lewis691/led-matrix-sim/reports/geometry/head-space-walkthrough.html

# Head space walkthrough

WT - Lewis.dxf (de-tilted 12°) overlaid with the Head 1 Assembly STEP. Model frame, mm: origin at the top-arc centre, +y up, +z out of the face. Step through below, or use the arrow keys.

## Front view, looking at the face (back-of-head parts seen through the board)

## Side section at x = 0 (face to the right, back of head to the left)

DXF / LED boarddiffusershell, bossescameraboard holesneck, mic, motorclear back patchrear-light candidatecentre line / camera height

Back

Next
