lewis691/led-matrix-sim/reports/full-head/full-head-60-optimized-report.pdf

# LeLamp Head: LED layout, light and heat

Generated 10/15/2026, 1:35:59 PM by Head LED Placement Studio · geometry from the Head STEP (gap 21 mm) · 60 LEDs at 55 mA, 3000 K, typical flux · dark room

## Summary

Light: 624 lm out (target 300), desk minimum 779 lx at 40 cm (target 500), evenness 6% (target 65%; outside the keepout corner: 88%). Only 40% of the LED light leaves through the diffuser; 42% is absorbed by the walls, chamfer and lip.
Heat (worst case): board 159 °C, LED chips 161 °C (datasheet limit 125), diffuser surface 102 °C, PLA bosses 159 °C (PLA softens ≈ 55 °C). 12.17 W in: LEDs 7.57 W + electronics 4.60 W.
Biggest passive lever: Black back + aluminium standoffs + Al Head Back → board 73 °C (-86 °C).
Warm-up: 95% of the temperature rise after 32 min; bench runs should last at least that long.
Fails: Evenness, Board temperature, LED junction, PLA bosses touching the board, Diffuser outside (touch), LED power, Supply headroom.

## Designs compared

Design | Gap | Current | Evenness | Variation | Light out | Desk min / avg | Board / LED chip | PLA bosses | Diffuser surface | LED power | Light: out / walls / camera ring
This design | 21 mm | 55 mA | 6% (outside the keepout corner 88%) | 21.9% | 624 lm | 779 / 961 lx | 159 / 161 °C | 159 °C | 102 °C | 8.91 W | 40% / 42% / 0.07%
Baseline: hex grid (21 mm, 55 mA) | 21 mm | 55 mA | 1% (outside the keepout corner 32%) | 39.4% | 742 lm | 906 / 1144 lx | 160 / 161 °C | 159 °C | 102 °C | 8.91 W | 48% / 31% / 0.04%

Every design is recomputed with the current model (heat: worst case). Targets: brief (300 lm, 65 %, 40 °C, 4 W, provisional); desk 500 lx at 40 cm (Ben's Notion, EN 12464-1); LED chip 125 °C (Cree Pro9 datasheet).

## This design

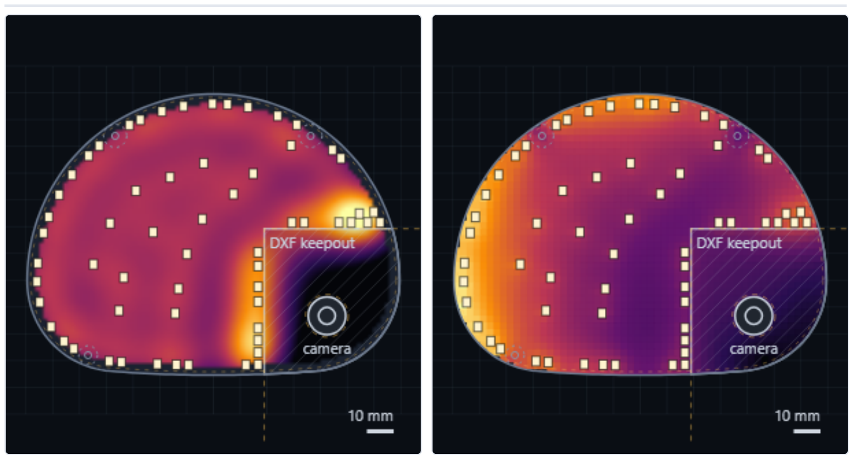
[picture p5: figure]

Diffuser brightness (yellow bright, purple dark), with the LED layout. Board temperature map (worst case): 156.9–159.5 °C.
Where the light goes
Destination | Share | Lumens
Out through the diffuser | 40% | 624
Absorbed / scattered in the diffuser | 17% | 267
Walls, chamfer and lip (dark PLA) | 42% | 649
Camera barrel | 0.5% | 8.3
Escapes undiffused round the camera | 0.07% | 1.1

Heat

Quantity | Value
Heat in | 12.17 W (LEDs 7.57 + electronics 4.60)
Leaves via | front 8.95 W · back cavity 2.77 W · bosses 0.46 W
Board hottest / coolest | 159.5 / 156.9 °C
Hottest LED chip | 161.1 °C (limit 125)
Diffuser outer surface (max) | 101.9 °C
Head Back inside / outside | 38.5 / 36.7 °C
Ben's network (LEDs only, front only) | 144.0 °C

Warm-up after switch-on

Orange: hottest board point; blue: diffuser; purple: shell. 63 % of the rise after 10 min, 95 % after 32 min. Lumped 3-node model; heat capacities from STEP volumes × typical material values (assumed).

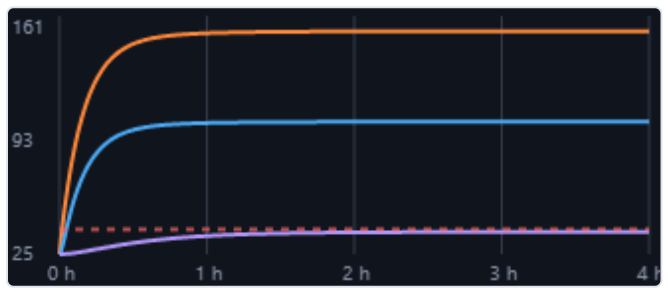
[picture p6: figure]

Passive cooling what-ifs (one change each)

Option | Board | Change | LED chip | PLA bosses
Board back painted / anodised black emissivity 0.1 → 0.9 (bare vs black-anodised aluminium, typical) | 116 °C | -43 °C | 118 °C | 116 °C
Aluminium standoffs instead of PLA bosses boss k 0.13 → 138 W/m·K | 158 °C | -2 °C | 159 °C | 156 °C
Head Back in PC instead of PLA wall k 0.13 → 0.2 W/m·K (Ben's PC value) | 158 °C | -1 °C | 160 °C | 157 °C
Head Back in aluminium wall k → 138 W/m·K; outside emissivity 0.85 (anodised, typical) | 154 °C | -6 °C | 155 °C | 153 °C
Electronics at typical power your table: 2.0 W instead of 4.6 W worst case | 139 °C | -21 °C | 140 °C | 138 °C
Electronics off this board LED heat only (as in Ben's calc) | 121 °C | -38 °C | 123 °C | 120 °C
Black back + aluminium standoffs + Al Head Back the three passive changes together | 73 °C | -86 °C | 75 °C | 64 °C

Which assumption matters most (one at a time)

Input | Range | Board low → high
Board back emissivity | bare 0.05 – painted 0.9 (finish unknown) | 166 → 116 °C
Air movement (Ben's cases) | Ben: Nu 1–3, h 2–25 | 113 → 159 °C
Electronics power | your table: 2.0 typical – 4.6 W worst | 139 → 159 °C
LED heat share k_h | Hui & Qin: 0.85; Qin & Hui: 85–90 % | 156 → 163 °C
Room temperature | 20–30 °C | 157 → 162 °C
PLA conductivity | 0.10–0.20 W/m·K (filament unknown) | 160 → 158 °C
Dielectric k (chip only) | MCPCB 1–3 W/m·K | 161 → 162 °C (chip)
Aluminium thickness | MCPCB 1.0–2.0 mm (stack-up unknown) | 160 → 159 °C
Shell emissivity | 0.80–0.95 | 160 → 159 °C

## Constraint checklist

| Check | Now | Limit | Limit from
✓ | Light out | 624 lm | ≥ 300 lm | Brief (provisional 300 lm)
✓ | Desk light (min) | 779 lx | ≥ 500 lx | Ben's Notion target (EN 12464-1)
✕ | Evenness | 6 % whole face (outside the keepout corner 88 %) | ≥ 65 % | Brief (provisional 65 %); scored over the whole lit face unless set to outside the keepout corner
✕ | Board temperature | 159.5 °C | ≤ 40 °C | Brief (provisional 40°C goal)
✕ | LED junction | 161.1 °C | ≤ 125 °C | Cree Pro9 datasheet p.4 (Tj max)
✕ | PLA bosses touching the board | 158.5 °C | ≤ 55 °C | PLA glass transition ≈ 55–60 °C (textbook); bosses from the STEP
✓ | Head Back inside (PLA) | 38.5 °C | ≤ 55 °C | PLA glass transition ≈ 55–60 °C (textbook)
✕ | Diffuser outside (touch) | 101.9 °C | ≤ 40 °C | Brief's 40°C goal applied to the touch point it asks you to probe
✕ | LED power | 8.91 W | ≤ 4 W | Brief / heat-calc doc (4 W reference)
✓ | Placement | 0 LED(s) break a limit | 0 | DXF outline, lens, screw holes, 2835 body size
✓ | Driver current | 55.0 mA | ≤ 60.5 mA | R82 = 820 Ω (Head_Board.pdf); 41 × 1.21 V / R from the TLC59711 datasheet (not in the context files)
✓ | LED current rating | 55.0 mA | ≤ 480 mA | Cree Pro9 datasheet p.4
✓ | Ambient rating | 25 °C | -40 to 105 °C | Cree Pro9 datasheet p.4
✕ | Supply headroom | -0.13 V | ≥ 0.4 V | LMR51420 divider (13.37 V) − 5 × Vf; TLC59711 regulation
✓ | Driver channels | 12 strings | ≤ 12 | TLC59711 (12 channels)

## Assumptions and values not in the project files

Item | Value | Basis
Driver current limit | 60.5 mA | R82 = 820 Ω from Head_Board.pdf × TLC59711 formula 41 × 1.21 V / R (datasheet not in the project files; its channel rating is 60 mA)
LED supply VDD_LED | 13.37 V | 100k/4.7k divider from Head_Board.pdf × LMR51420 0.6 V reference (datasheet not in the project files)
Regulation headroom limit | 0.4 V | my engineering choice
Metal-core stack-up | 1.6 mm Al k 138, 1 oz Cu, 0.1 mm dielectric k 2, back ε 0.1 | typical values until the PCB stack-up exists
PLA properties | k 0.13, ε 0.9, softens ≈ 55–60 °C | typical values; check the filament datasheet
Electronics placement | spread evenly | positions unknown
FR4 comparison | in-plane k 0.8, 1.6 mm | typical laminate value (comparison only)
Heat capacities (warm-up) | Al 2700 kg/m³ × 900, PC 1200 × 1200, PLA 1240 × 1800 J/kg·K | typical material values; volumes from the STEP
What-if materials | black back ε 0.9, Al standoffs/shell k 138, PC k 0.2, anodised ε 0.85 | typical values; PC k is Ben's value
Sensitivity ranges | e.g. back ε 0.05–0.9, PLA k 0.10–0.20, Al 1–2 mm, room 20–30 °C | typical spreads; air cases from Ben, power range from your table
Desk reflectance (Real look only) | 0.5 | display only
LED colour on screen | blackbody fit | Tanner Helland approximation (display only)
Optimizer settings, colour thresholds, clearances | e.g. penalty 50, 1.3 / 1.0 / 3.5 / 4.5 mm | my engineering choices (speed and safety margins, not physics)
Papers not in the project files | Su 2012, Du/Faber/Gunzburger 1999, Bridson 2007 | cited for algorithms only (optimizer, Even out, Randomize); context/papers holds Moreno, Yang, Hui & Qin

All other values trace to the Cree Pro9 datasheet, the Head STEP, Head_Board.pdf, the brief, Ben's Notion pages, the cited papers, or your answers. Full list: the app's Evidence panel (step 5) / evidence.js.

## Build record: LED positions

mm from the head's left / bottom edges (the dome centre is at x = 69.55, y = 35.47 in these units). Nearest-neighbour spacing 4.5–15.5 mm.

LED | String | Duty | x from left | y from bottom
1 | 12 | 100% | 30.62 | 5.24
2 | 11 | 100% | 86.21 | 12.99
3 | 9 | 100% | 8.93 | 18.08
4 | 8 | 100% | 56.52 | 32.31
5 | 11 | 100% | 86.21 | 8.45
6 | 11 | 100% | 55.71 | 3.88
7 | 11 | 100% | 81.70 | 3.80
8 | 6 | 100% | 30.96 | 56.72
9 | 11 | 100% | 60.24 | 3.77
10 | 10 | 100% | 86.22 | 27.46
11 | 8 | 100% | 86.22 | 32.99
12 | 10 | 100% | 86.22 | 3.94
13 | 7 | 100% | 8.02 | 59.10
14 | 4 | 100% | 65.94 | 79.17
15 | 8 | 100% | 86.22 | 40.75
16 | 10 | 100% | 34.32 | 24.11
17 | 3 | 100% | 16.69 | 74.83
18 | 10 | 100% | 86.22 | 17.58
19 | 7 | 100% | 3.95 | 41.86
20 | 12 | 100% | 13.77 | 12.67
21 | 8 | 100% | 86.21 | 45.89
22 | 9 | 100% | 4.70 | 27.24
23 | 10 | 100% | 55.27 | 23.11
24 | 3 | 100% | 38.15 | 93.39
25 | 9 | 100% | 36.07 | 36.50
26 | 7 | 100% | 47.06 | 53.42
27 | 12 | 100% | 35.17 | 4.87
28 | 7 | 100% | 6.08 | 53.14
29 | 6 | 100% | 98.90 | 57.02
30 | 2 | 100% | 98.55 | 85.79
31 | 1 | 100% | 50.32 | 98.52
32 | 8 | 100% | 59.65 | 45.25
33 | 9 | 100% | 24.76 | 41.41
34 | 2 | 100% | 113.98 | 84.12
35 | 5 | 100% | 124.06 | 60.30
36 | 7 | 100% | 11.91 | 67.38

LED | String | Duty | x from left | y from bottom
37 | 3 | 100% | 22.93 | 81.98
38 | 12 | 100% | 17.41 | 9.86
39 | 1 | 100% | 74.82 | 101.17
40 | 6 | 100% | 65.43 | 58.28
41 | 4 | 100% | 53.37 | 73.92
42 | 3 | 100% | 26.88 | 85.68
43 | 2 | 100% | 93.57 | 96.85
44 | 1 | 100% | 42.22 | 95.34
45 | 2 | 100% | 82.50 | 100.10
46 | 9 | 100% | 3.65 | 34.96
47 | 2 | 100% | 100.69 | 93.53
48 | 3 | 100% | 40.60 | 68.86
49 | 5 | 100% | 129.49 | 60.91
50 | 12 | 100% | 48.64 | 4.15
51 | 4 | 100% | 84.43 | 75.28
52 | 1 | 100% | 58.40 | 100.43
53 | 6 | 100% | 103.44 | 57.02
54 | 1 | 100% | 69.19 | 101.37
55 | 5 | 100% | 116.44 | 57.02
56 | 4 | 100% | 117.22 | 80.99
57 | 5 | 100% | 120.97 | 57.02
58 | 5 | 100% | 127.16 | 57.02
59 | 6 | 100% | 77.05 | 67.64
60 | 4 | 100% | 131.79 | 57.04

## Method and sources (short)

Light: each LED a cos^m (m = 1 from the 120° beam) source onto the diffuser at the optical height (17.9 − 0.62 mm), Moreno 2006 Eq. 1 × incidence cosine = Ben's derivation; walls absorb; diffuser transmission 0.70.
Desk: each diffuser patch a Lambertian source onto the desk plane (Ben's method). Evenness = darkest/average (brief); variation = CV (Yang 2009, Su 2012).
Heat: 2-D board conduction + Ben's front network + back cavity (STEP depths) + PLA bosses with radial spreading into the shell; LED heat k_h = 0.85 (Hui & Qin 2009); reduces exactly to Ben's network (check 20).
Checks: node checks/examples.js (26 checks against the sources) in the project repository.
