lewis691/led-matrix-sim/reports/bench/bench-B-optimized-20-led-coordinates.csv

led | string | position_in_string | x_mm | y_mm | nearest_neighbour_mm
1 | 3 | 3 | -65.58 | -4.82 | 24.30
2 | 3 | 4 | -52.57 | -25.34 | 23.65
3 | 3 | 5 | -28.98 | -27.00 | 23.65
4 | 2 | 2 | 16.64 | -30.76 | 22.01
5 | 1 | 2 | -39.83 | 3.33 | 27.01
6 | 2 | 1 | -5.35 | -31.81 | 22.02
7 | 2 | 3 | 16.66 | -8.75 | 22.01
8 | 3 | 2 | -62.37 | 21.29 | 23.16
9 | 1 | 3 | -25.32 | 28.91 | 27.40
10 | 1 | 1 | -12.14 | 0.17 | 27.87
11 | 2 | 4 | 16.64 | 13.27 | 22.02
12 | 4 | 5 | 39.82 | 21.55 | 22.09
13 | 4 | 4 | 61.90 | 21.55 | 22.01
14 | 3 | 1 | -51.16 | 41.55 | 23.16
15 | 1 | 4 | -31.38 | 57.93 | 22.05
16 | 2 | 5 | 1.21 | 35.72 | 27.24
17 | 4 | 2 | 29.66 | 51.66 | 22.04
18 | 4 | 3 | 51.59 | 40.99 | 22.01
19 | 1 | 5 | -10.51 | 65.04 | 22.05
20 | 4 | 1 | 11.96 | 64.80 | 22.04
