lewis691/led-matrix-sim/reports/bench/bench-baseline-and-A-hex-20-led-coordinates.csv

led | string | position_in_string | x_mm | y_mm | nearest_neighbour_mm
1 | 3 | 5 | -56.34 | -16.07 | 23.27
2 | 3 | 4 | -33.07 | -16.07 | 23.27
3 | 3 | 2 | -9.81 | -16.07 | 23.27
4 | 3 | 1 | 13.46 | -16.07 | 23.27
5 | 1 | 1 | -44.71 | 4.08 | 23.27
6 | 3 | 3 | -21.44 | 4.08 | 23.27
7 | 1 | 5 | 1.83 | 4.08 | 23.27
8 | 1 | 2 | -56.34 | 24.23 | 23.27
9 | 1 | 3 | -33.07 | 24.23 | 23.27
10 | 1 | 4 | -9.81 | 24.23 | 23.27
11 | 4 | 4 | 13.46 | 24.23 | 23.27
12 | 4 | 3 | 36.73 | 24.23 | 23.27
13 | 4 | 2 | 59.99 | 24.23 | 23.27
14 | 2 | 5 | -44.71 | 44.38 | 23.27
15 | 2 | 4 | -21.44 | 44.38 | 23.27
16 | 4 | 5 | 1.83 | 44.38 | 23.27
17 | 2 | 1 | 25.09 | 44.38 | 23.27
18 | 4 | 1 | 48.36 | 44.38 | 23.27
19 | 2 | 3 | -9.81 | 64.53 | 23.27
20 | 2 | 2 | 13.46 | 64.53 | 23.27
