lewis691/led-matrix-sim/reports/full-head/full-head-60-optimized-led-coordinates.csv

led | string | x_mm | y_mm | nearest_neighbour_mm
1 | 12 | -38.93 | -30.23 | 4.56
2 | 11 | 16.66 | -22.48 | 4.55
3 | 9 | -60.62 | -17.39 | 7.26
4 | 8 | -13.03 | -3.16 | 9.28
5 | 11 | 16.66 | -27.02 | 4.51
6 | 11 | -13.84 | -31.59 | 4.53
7 | 11 | 12.15 | -31.67 | 4.52
8 | 6 | -38.59 | 21.25 | 15.50
9 | 11 | -9.31 | -31.70 | 4.53
10 | 10 | 16.67 | -8.01 | 5.53
11 | 8 | 16.67 | -2.48 | 5.53
12 | 10 | 16.67 | -31.53 | 4.51
13 | 7 | -61.53 | 23.63 | 6.27
14 | 4 | -3.61 | 43.70 | 13.63
15 | 8 | 16.67 | 5.28 | 5.14
16 | 10 | -35.23 | -11.36 | 12.51
17 | 3 | -52.86 | 39.36 | 8.85
18 | 10 | 16.67 | -17.89 | 4.58
19 | 7 | -65.60 | 6.39 | 6.91
20 | 12 | -55.78 | -22.80 | 4.59
21 | 8 | 16.66 | 10.42 | 5.14
22 | 9 | -64.85 | -8.23 | 7.79
23 | 10 | -14.28 | -12.36 | 9.28
24 | 3 | -31.40 | 57.92 | 4.51
25 | 9 | -33.48 | 1.02 | 12.33
26 | 7 | -22.49 | 17.95 | 15.01
27 | 12 | -34.38 | -30.60 | 4.56
28 | 7 | -63.47 | 17.67 | 6.27
29 | 6 | 29.35 | 21.55 | 4.54
30 | 2 | 29.00 | 50.32 | 8.03
31 | 1 | -19.23 | 63.05 | 8.31
32 | 8 | -9.90 | 9.78 | 13.32
33 | 9 | -44.79 | 5.94 | 12.33
34 | 2 | 44.43 | 48.65 | 4.51
35 | 5 | 54.52 | 24.83 | 4.51
36 | 7 | -57.64 | 31.91 | 8.85
37 | 3 | -46.62 | 46.51 | 5.41
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
