lewis691/led-matrix-sim/reports/bench/bench-strings-B-back.png

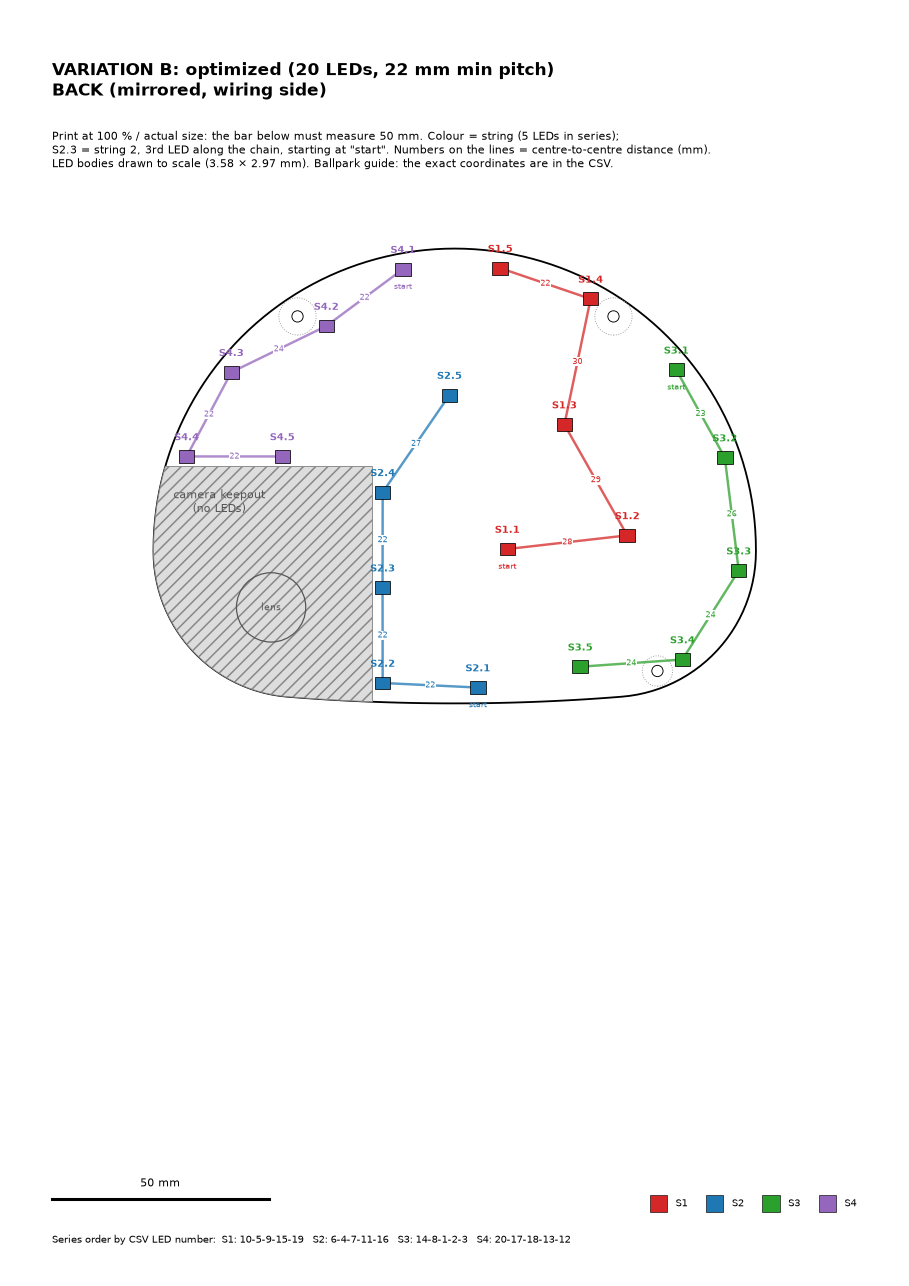
reports/bench/bench-strings-B-back.png
