lewis691/led-matrix-sim/reports/bench/bench-strings-B-front.png

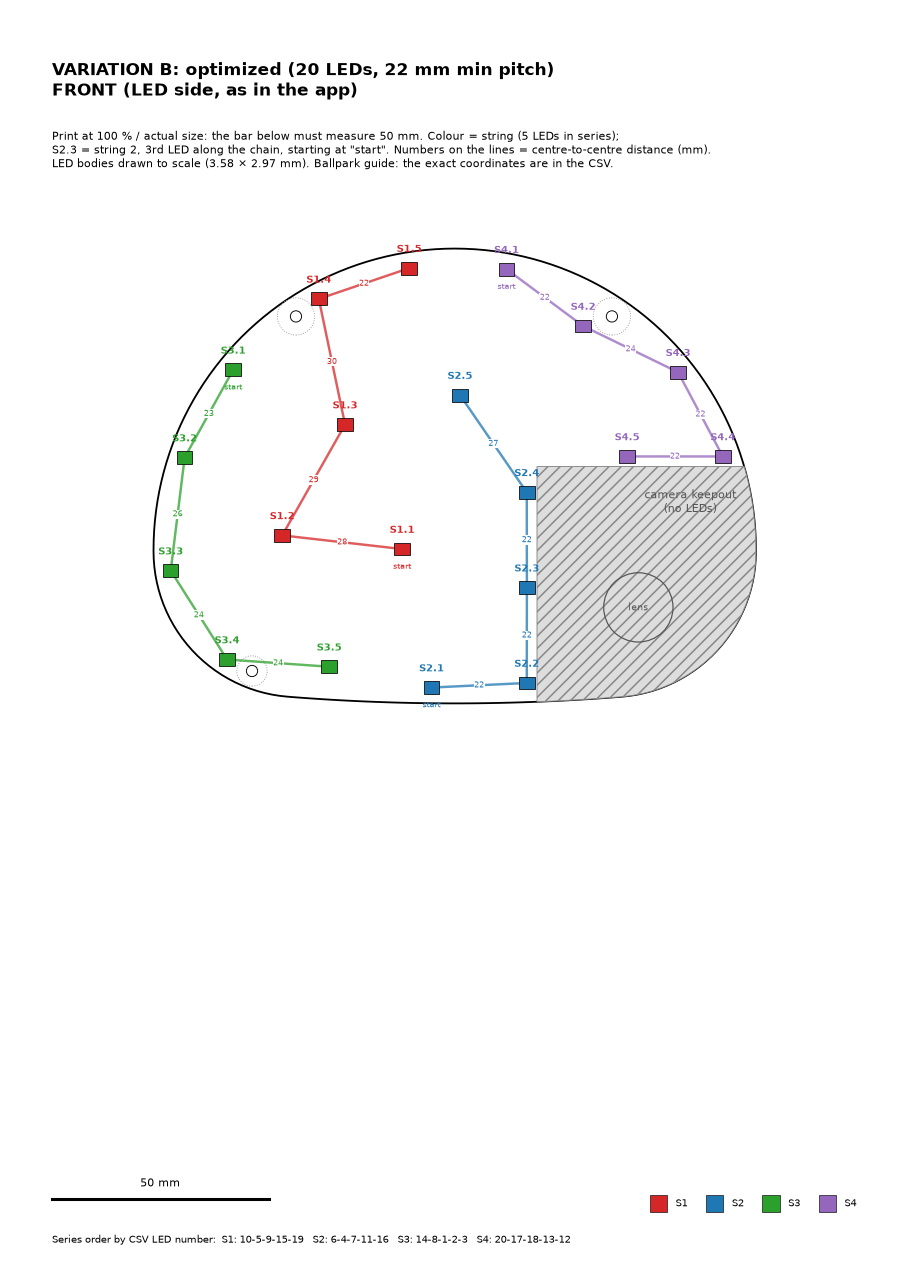
reports/bench/bench-strings-B-front.png
