lewis691/led-matrix-sim/reports/bench/bench-strings-hex-back.png

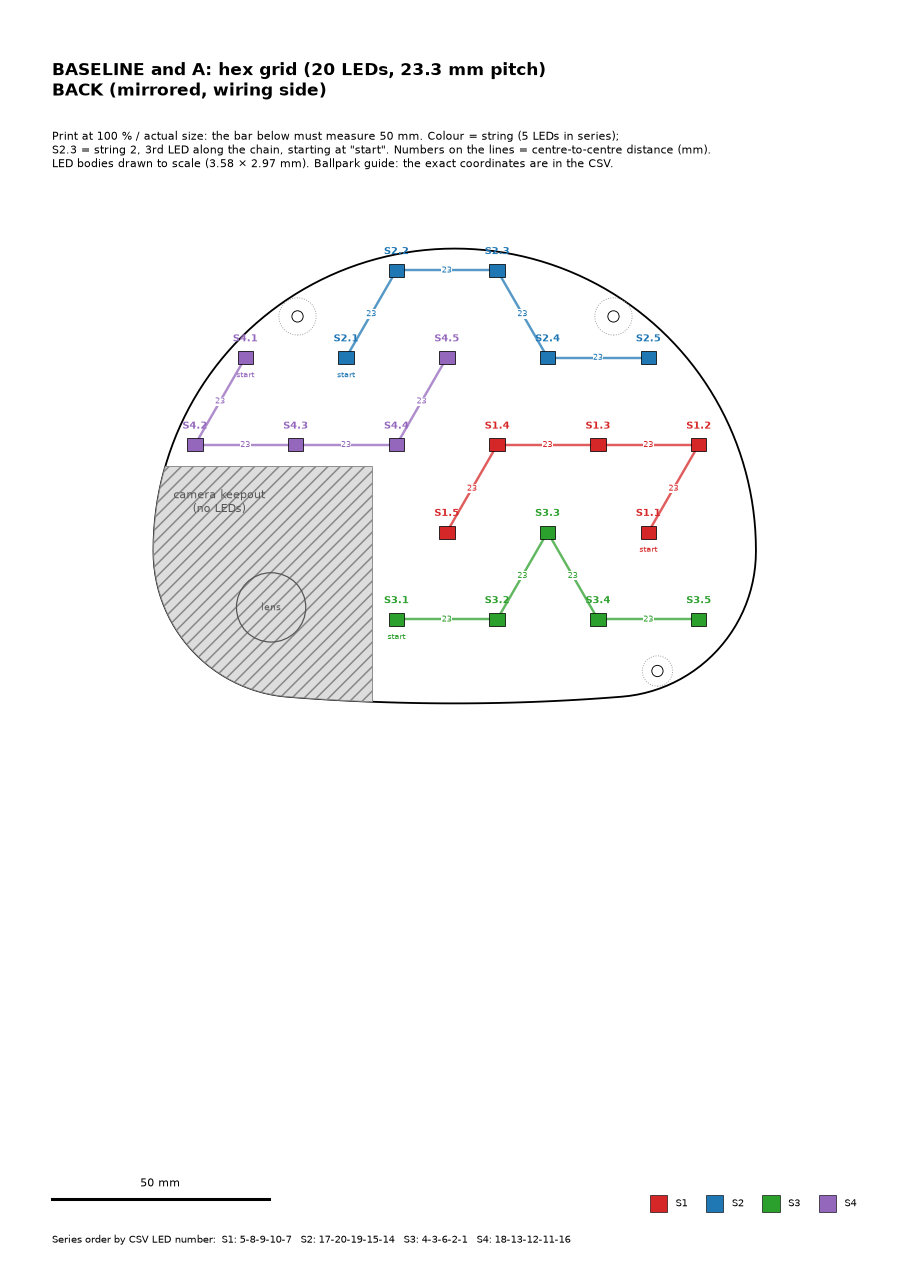
reports/bench/bench-strings-hex-back.png
