lewis691/led-matrix-sim/reports/full-head/full-head-60-optimized-layout.dxf

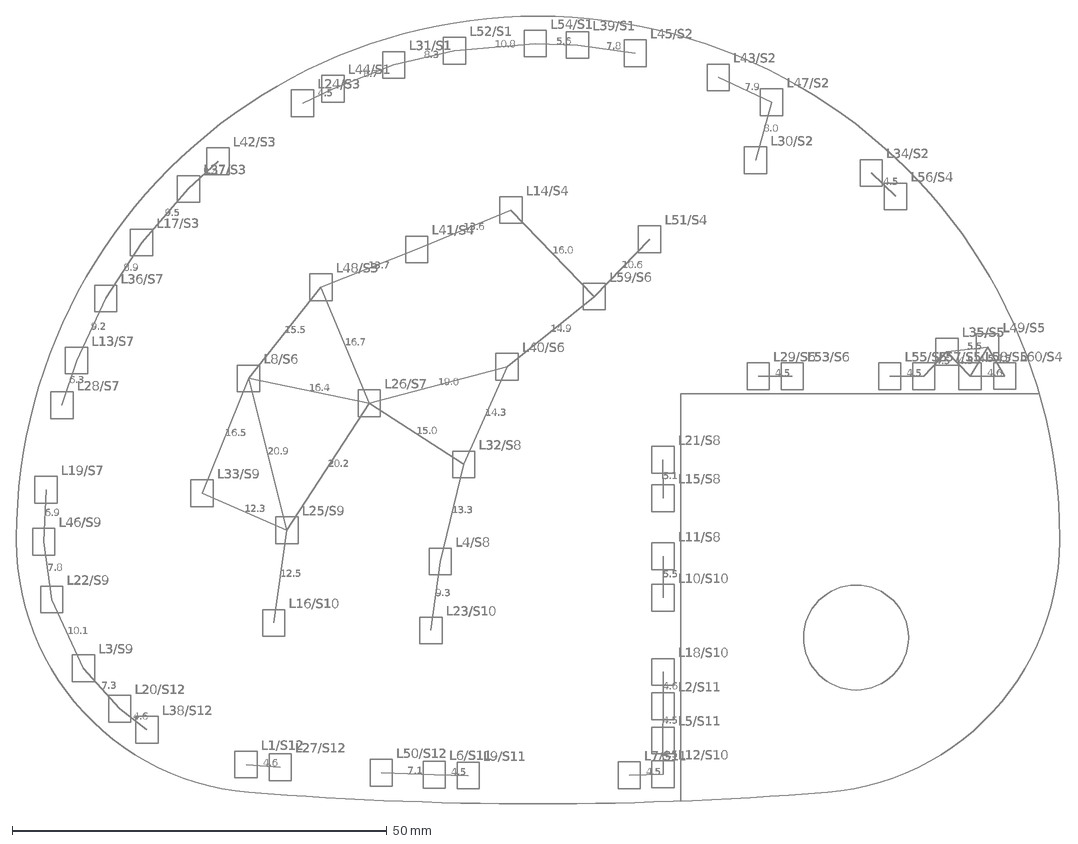
[picture p10: CAD file, 2026-10-15]
reports/full-head/full-head-60-optimized-layout.dxf
L1/S12
L2/S11
L3/S9
L4/S8
L5/S11
L6/S11
L7/S11
L8/S6
L9/S11
L10/S10
L11/S8
L12/S10
L13/S7
L14/S4
L15/S8
L16/S10
L17/S3
L18/S10
L19/S7
L20/S12
L21/S8
L22/S9
L23/S10
L24/S3
L25/S9
L26/S7
L27/S12
L28/S7
L29/S6
L30/S2
L31/S1
L32/S8
L33/S9
L34/S2
L35/S5
L36/S7
L37/S3
L38/S12
L39/S1
L40/S6
L41/S4
L42/S3
L43/S2
L44/S1
L45/S2
L46/S9
L47/S2
L48/S3
L49/S5
L50/S12
L51/S4
L52/S1
L53/S6
L54/S1
L55/S5
L56/S4
L57/S5
L58/S5
L59/S6
L60/S4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
