lewis691/led-matrix-sim/assets/cad/Neck.stl

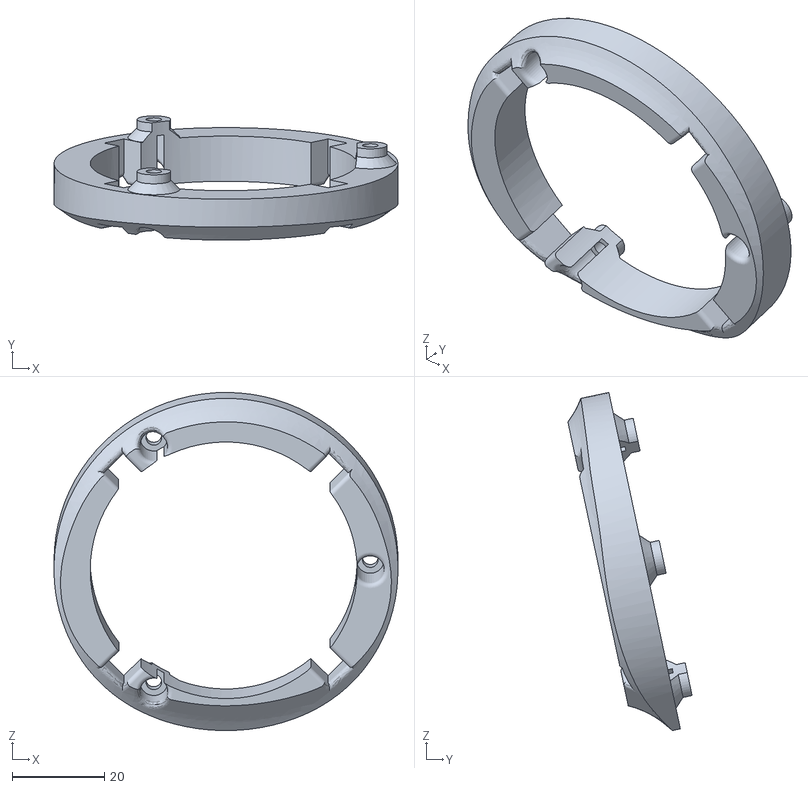
[picture p11: CAD file, 2026-10-15]
assets/cad/Neck.stl
74.5 x 26.9 x 73.2
