lewis691/led-matrix-sim/reports/bench/bench-baseline-and-A-hex-20-layout.dxf

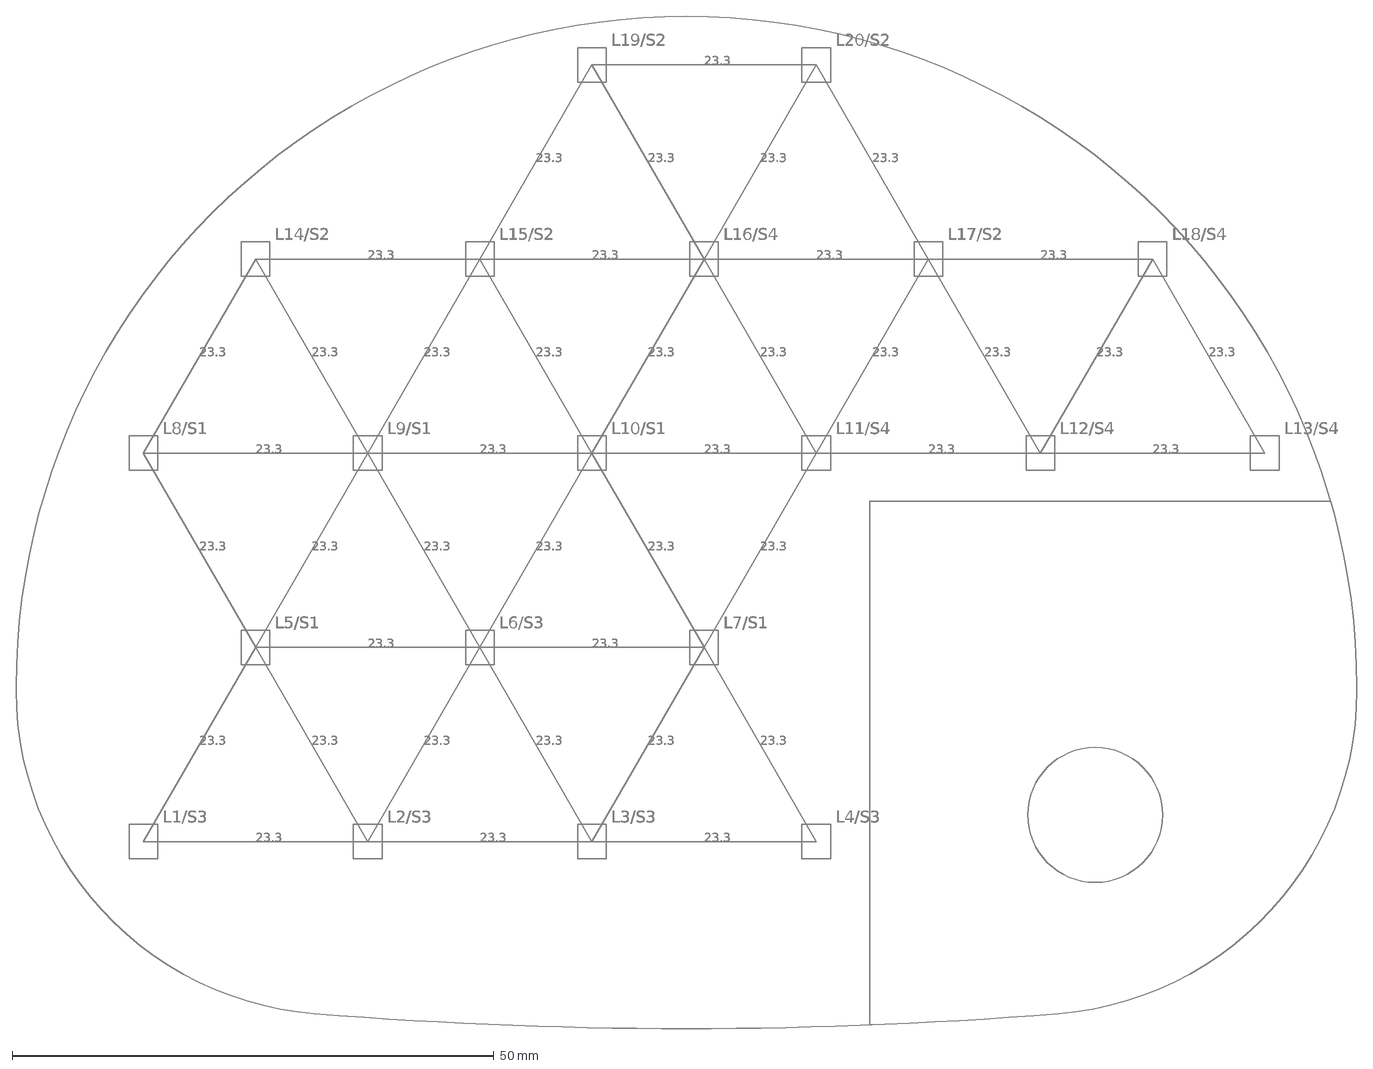
[picture p12: CAD file, 2026-10-15]
reports/bench/bench-baseline-and-A-hex-20-layout.dxf
L1/S3
L2/S3
L3/S3
L4/S3
L5/S1
L6/S3
L7/S1
L8/S1
L9/S1
L10/S1
L11/S4
L12/S4
L13/S4
L14/S2
L15/S2
L16/S4
L17/S2
L18/S4
L19/S2
L20/S2
23.3
