lewis691/led-matrix-sim/assets/cad/Diffuser.stl

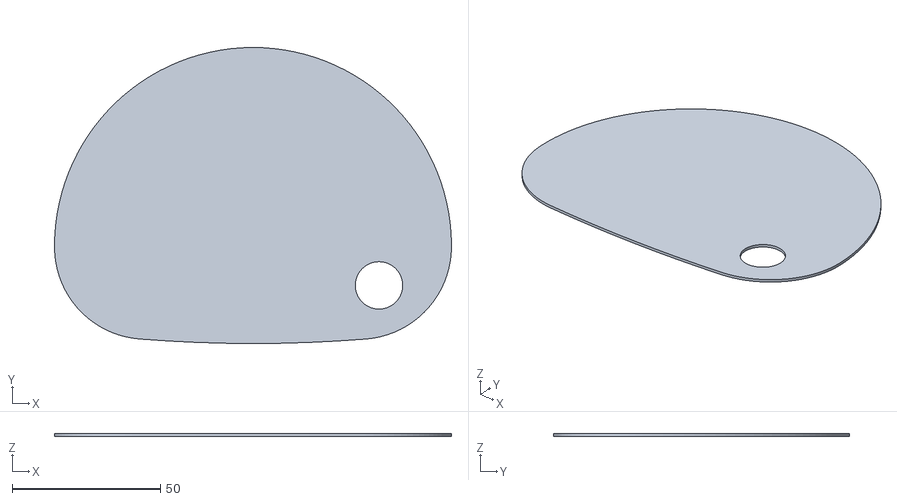
[picture p13: CAD file, 2026-10-15]
assets/cad/Diffuser.stl
133.9 x 99.9 x 1.00
