lewis691/led-matrix-sim/reports/bench/bench-B-optimized-20-layout.dxf

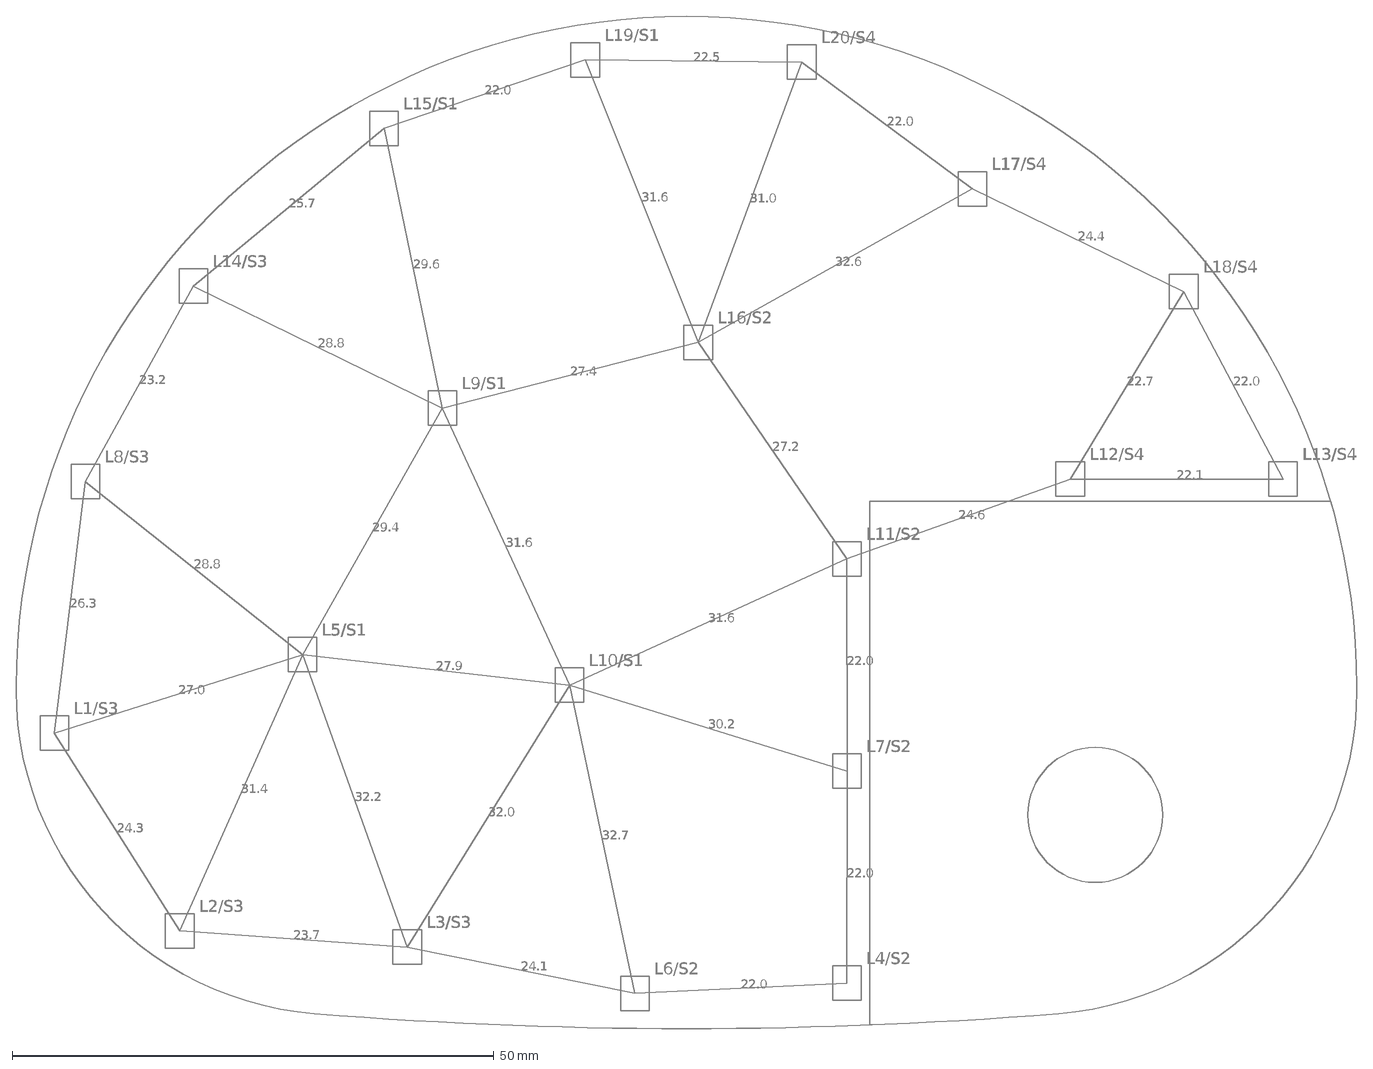
[picture p14: CAD file, 2026-10-15]
reports/bench/bench-B-optimized-20-layout.dxf
L1/S3
L2/S3
L3/S3
L4/S2
L5/S1
L6/S2
L7/S2
L8/S3
L9/S1
L10/S1
L11/S2
L12/S4
L13/S4
L14/S3
L15/S1
L16/S2
L17/S4
L18/S4
L19/S1
L20/S4
24.3
27.0
26.3
23.7
31.4
24.1
22.0
32.2
28.8
29.4
27.9
23.2
31.6
29.6
27.4
32.0
32.7
30.2
24.6
27.2
22.1
22.7
25.7
32.6
31.0
24.4
22.5
