lewis691/led-matrix-sim/assets/cad/Head_Back.stl

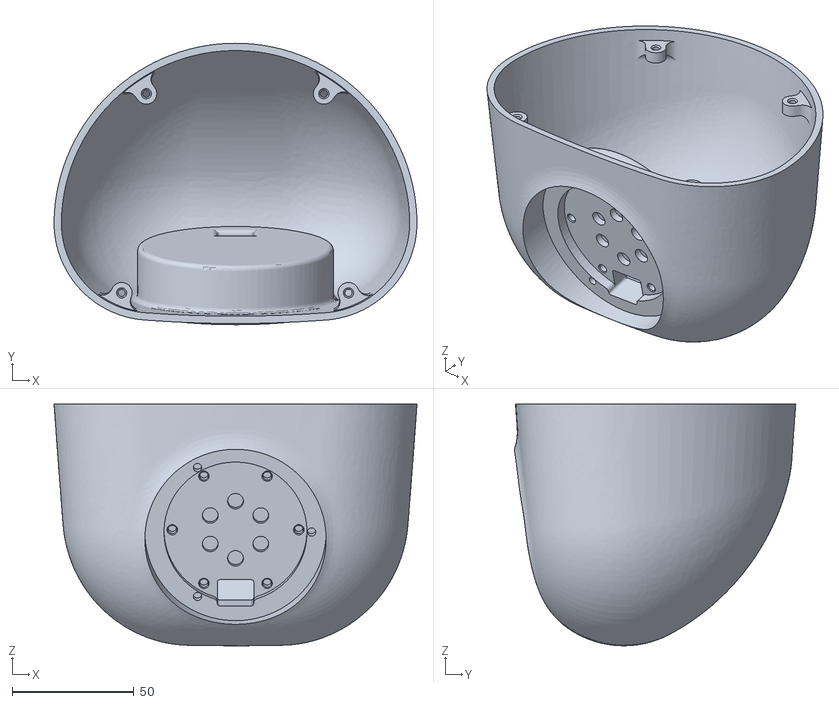
[picture p15: CAD file, 2026-10-15]
assets/cad/Head_Back.stl
149.2 x 115.7 x 99.3
