lewis691/led-matrix-sim/assets/cad/Mic_Array.stl

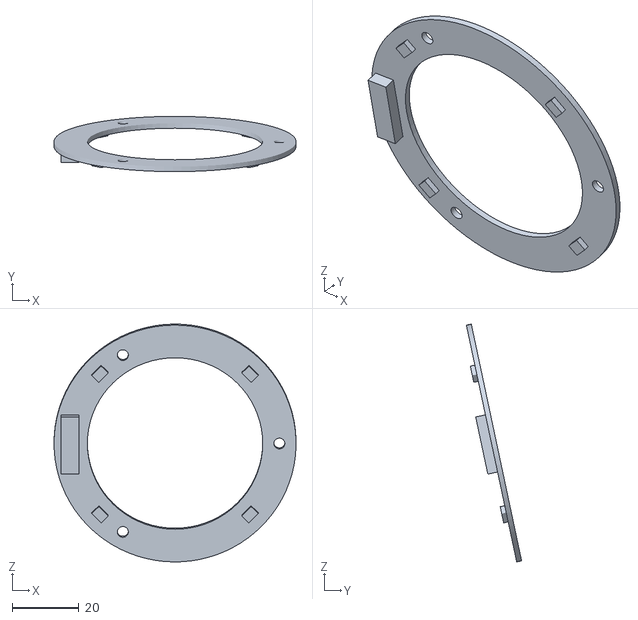
[picture p16: CAD file, 2026-10-15]
assets/cad/Mic_Array.stl
72.5 x 16.5 x 71.2
