lewis691/led-matrix-sim/assets/cad/DM_J3507_motor_ASSUMED_PLACEMENT.stl

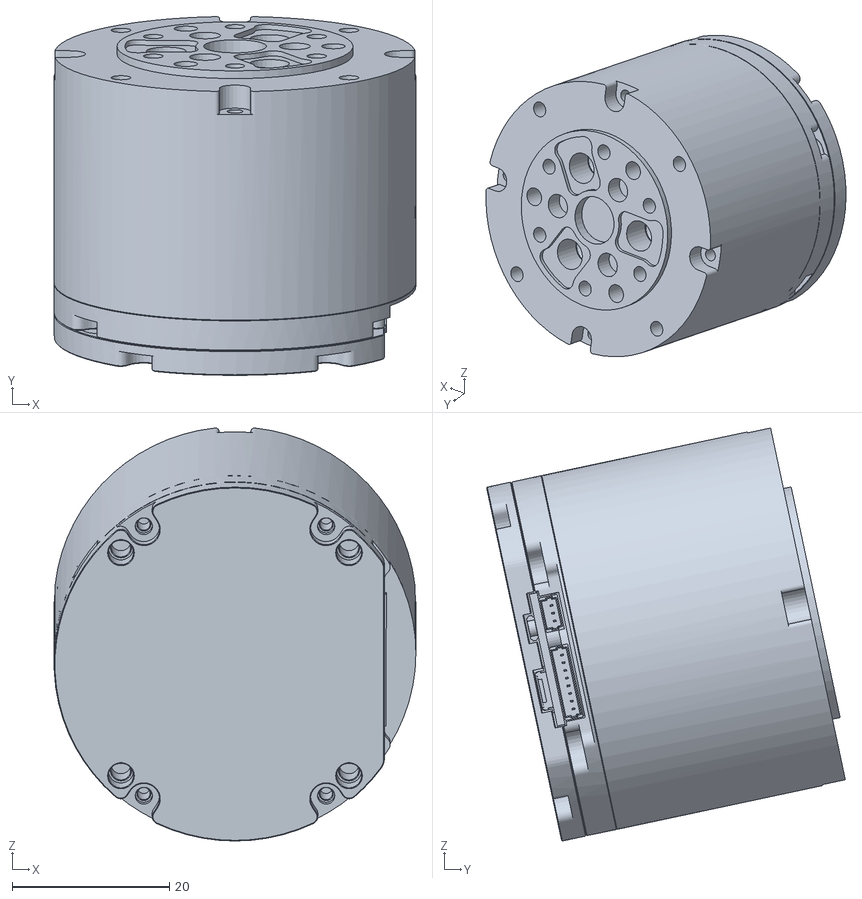
[picture p17: CAD file, 2026-10-15]
assets/cad/DM_J3507_motor_ASSUMED_PLACEMENT.stl
46.0 x 45.6 x 52.5
