lewis691/led-matrix-sim/assets/cad/DM_J3507_Mounting_Plate.stl

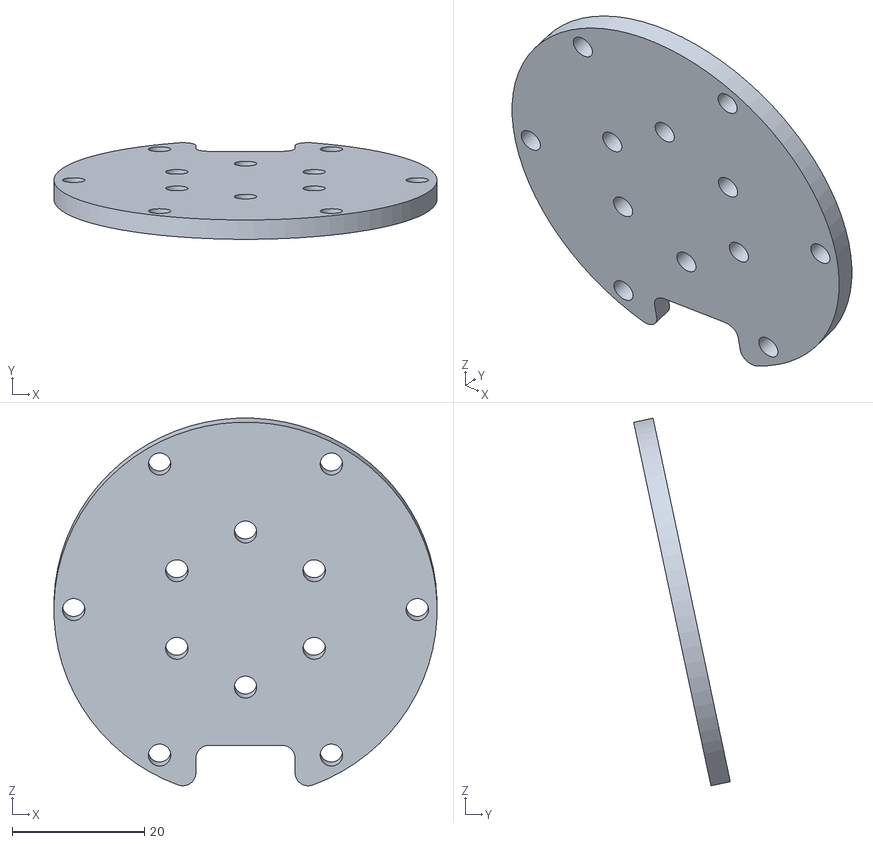
[picture p18: CAD file, 2026-10-15]
assets/cad/DM_J3507_Mounting_Plate.stl
58.0 x 14.6 x 55.6
