lewis691/led-matrix-sim/assets/cad/LED_Array.stl

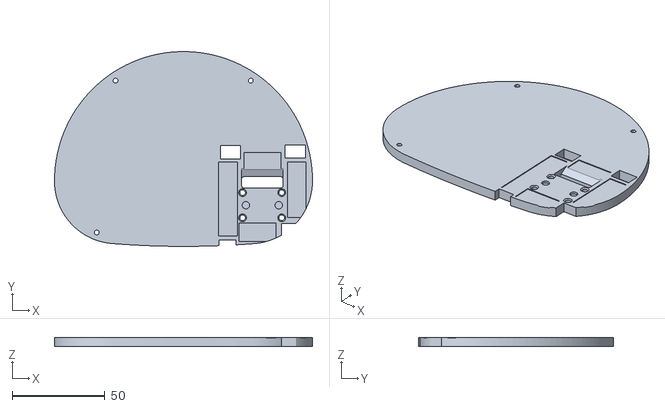
[picture p19: CAD file, 2026-10-15]
assets/cad/LED_Array.stl
139.1 x 105.0 x 5.00
