lewis691/led-matrix-sim/assets/cad/Head_Front.stl

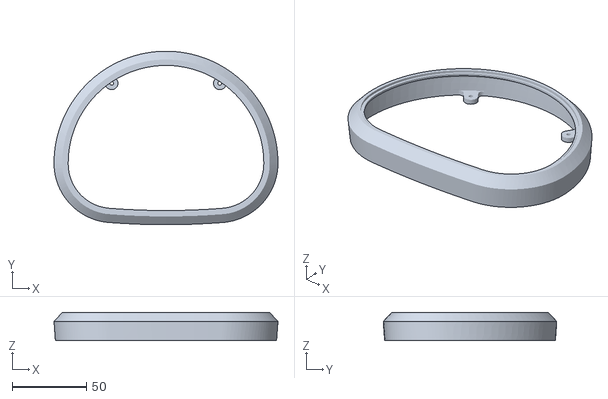
[picture p20: CAD file, 2026-10-15]
assets/cad/Head_Front.stl
151.1 x 117.0 x 18.9
