lewis691/led-matrix-sim/assets/cad/Camera.stl

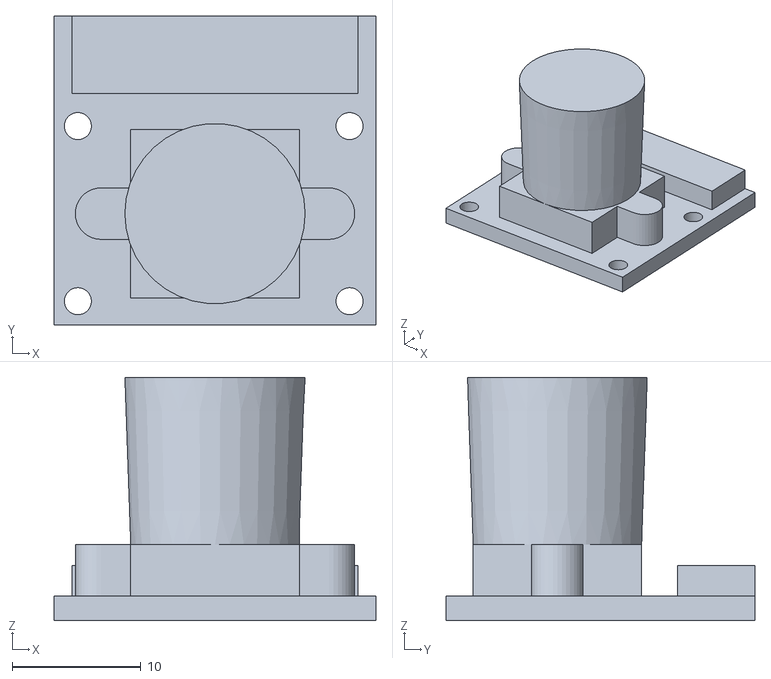
[picture p21: CAD file, 2026-10-15]
assets/cad/Camera.stl
25.0 x 24.0 x 18.9
