lewis691/led-matrix-sim/reports/bench/bench-string-maps.pdf

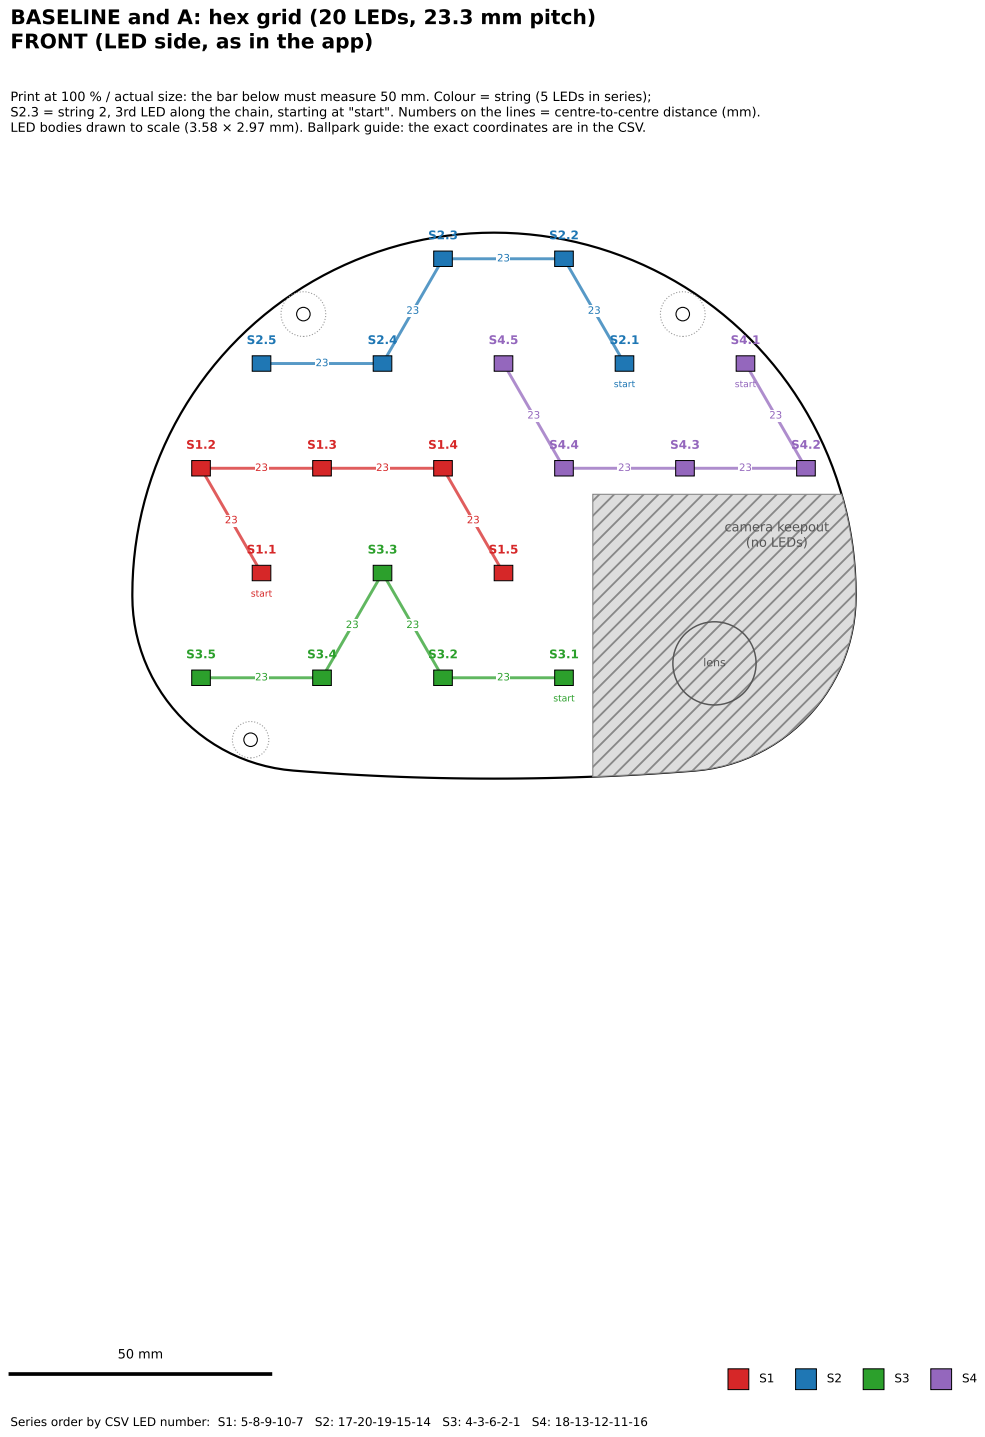
[picture p22: page 1]
camera keepout (no LEDs); lens; start

BASELINE and A: hex grid (20 LEDs, 23.3 mm pitch)
FRONT (LED side, as in the app)

Print at 100 % / actual size: the bar below must measure 50 mm. Colour = string (5 LEDs in series);
S2.3 = string 2, 3rd LED along the chain, starting at "start". Numbers on the lines = centre-to-centre distance (mm).
LED bodies drawn to scale (3.58 × 2.97 mm). Ballpark guide: the exact coordinates are in the CSV.

Series order by CSV LED number: S1: 5-8-9-10-7 S2: 17-20-19-15-14 S3: 4-3-6-2-1 S4: 18-13-12-11-16

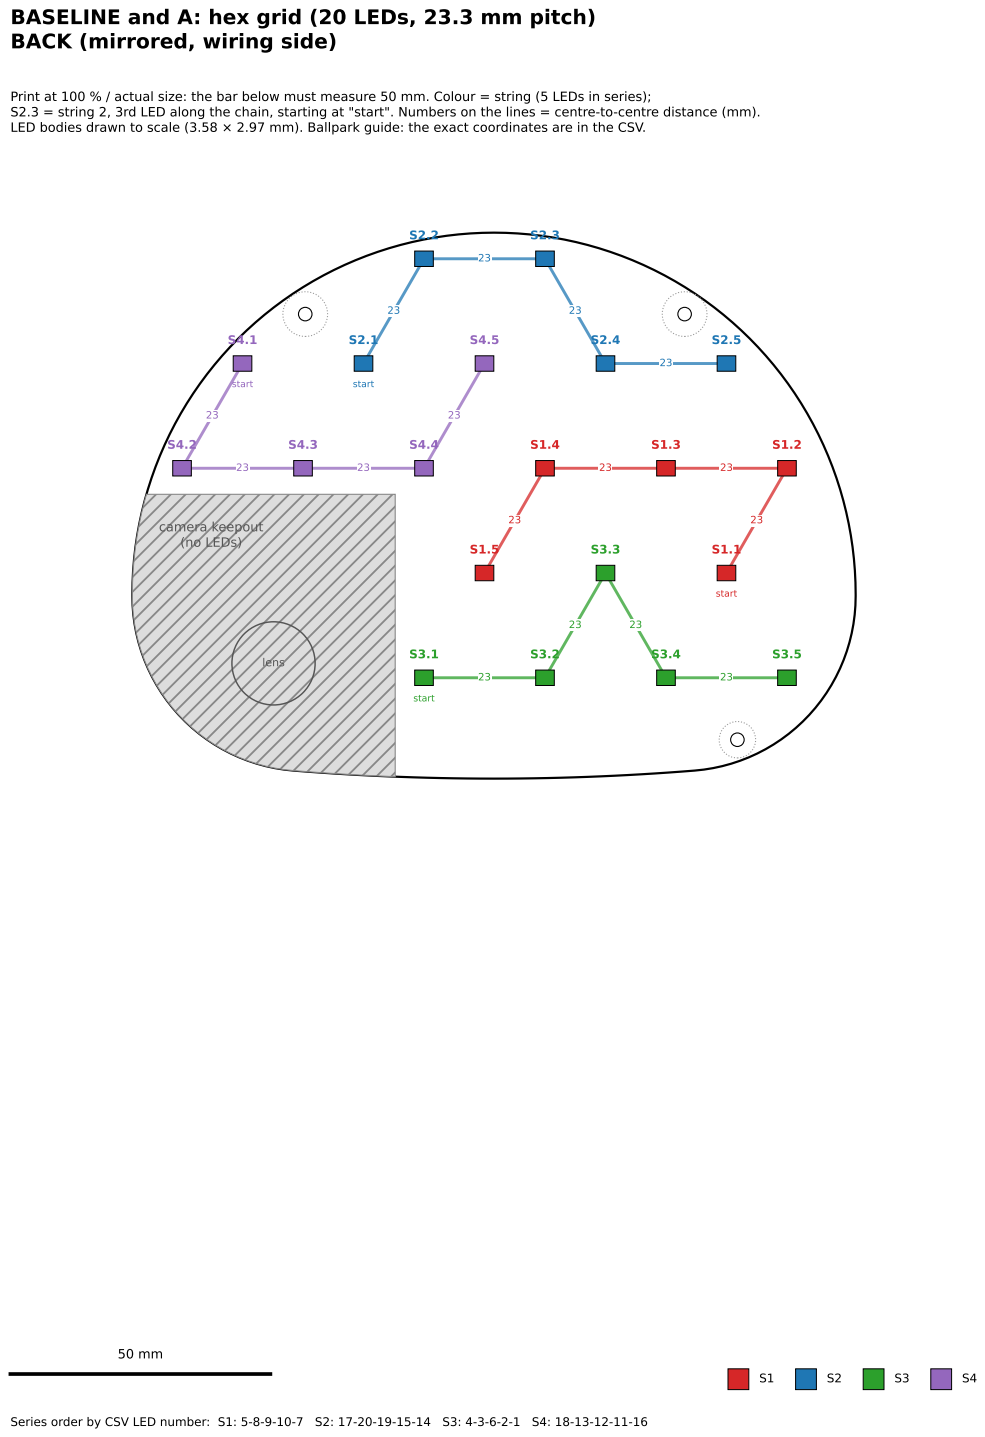
[picture p23: page 2]
camera keepout (no LEDs); lens; start

BASELINE and A: hex grid (20 LEDs, 23.3 mm pitch)
BACK (mirrored, wiring side)

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

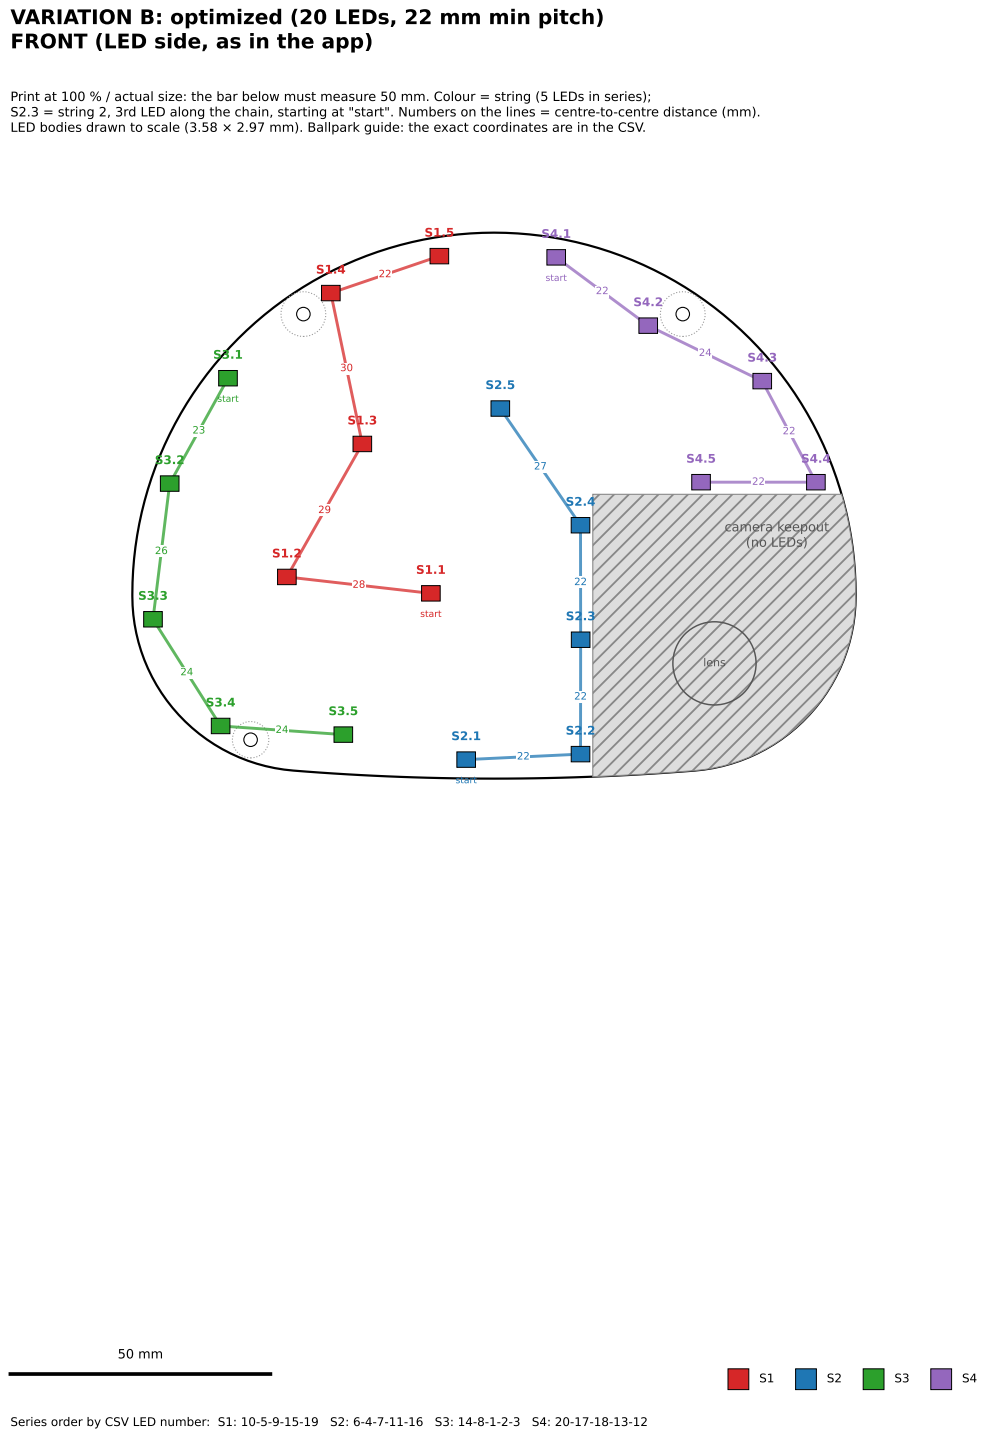
[picture p24: page 3]
camera keepout (no LEDs); lens; start

VARIATION B: optimized (20 LEDs, 22 mm min pitch)
FRONT (LED side, as in the app)

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

Series order by CSV LED number: S1: 10-5-9-15-19 S2: 6-4-7-11-16 S3: 14-8-1-2-3 S4: 20-17-18-13-12

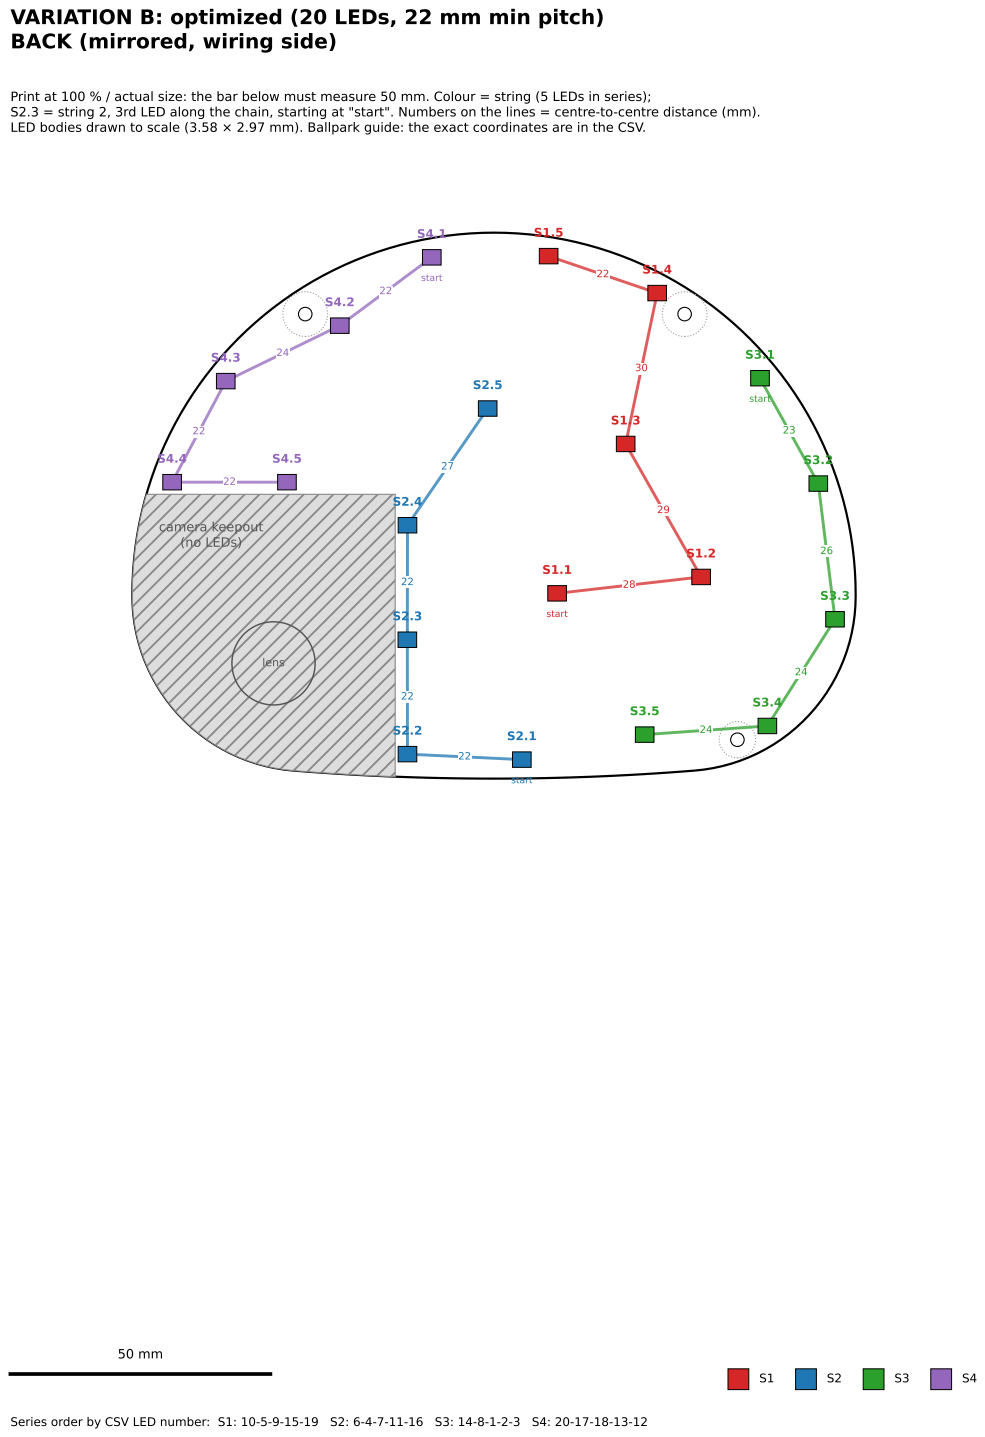
[picture p25: page 4]
camera keepout (no LEDs); lens; start

VARIATION B: optimized (20 LEDs, 22 mm min pitch)
BACK (mirrored, wiring side)

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
