lewis691/led-matrix-sim/(commit log)

2026-10-15 Head LED Placement Studio: LED layout, light and heat model for the LeLamp Head
    Browser tool (no build step) for placing the 60 Head LEDs: Lambertian light model,
    annealing optimizer, desk-light limit, string dimming, colour temperature, full board
    heat map, light budget, 3D compare and nightstand scene, all checked against sources
    (node checks/examples.js, 22 checks). Geometry measured from the Head STEP.
    [Camera.stl, DM_J3507_Mounting_Plate.stl, DM_J3507_motor_ASSUMED_PLACEMENT.stl, Diffuser.stl, Head_Back.stl, Head_Front.stl, LED_Array.stl, Mic_Array.stl]
2026-10-15 Thermal-camera view, evidence audit fixes, evidence panel, usability
    - 3D nightstand scene: thermal-camera look colouring only computed surfaces
    - Evidence audit: LED height 0.62 mm, package 3.58 x 2.97 mm, pad 6.47 mm2,
    front bosses 3 mm, Moreno citation corrected, unlabelled constants labelled
    - Evidence panel (step 5), cursor temperature/brightness readout, fix buttons
    - Saved designs migrate to the audited geometry (cadV 2)
2026-10-15 Report export, heat cutaway, warm-up, what-ifs, sensitivity, hot spots
    - One-click printable report: designs, maps, light budget, heat, warm-up,
    what-ifs, sensitivity, checklist, assumptions, LED build record
    - 3D heat cutaway with temperatures and heat-flow arrows; thermal camera
    scale fitted to visible surfaces
    - Warm-up (3-node RC), passive-cooling what-ifs, one-at-a-time sensitivity,
    electronics hot spots
    - Boss-to-shell radial spreading resistance (removes over-optimistic boss path)
    - Checks 23-24; notes and evidence updated
2026-10-15 Restore original DXF corner keepout as default; value review fixes
    - Default camera keepout is the original DXF corner (x >= 19.0, y <= 19.22 mm),
    which the new prototype uses; saved designs migrate (cadV 3). The whole lit
    face, including the corner, is still scored for evenness.
    - Current sweep and optimizer desk-limit flux now derate with the full heat
    map (was Ben's LED-only network); sweep bisects and warns when the chip
    exceeds 125 C. New check 25 confirms bisection = full scan.
    - Camera-hole cells no longer scored (auto-balance min/avg was pinned at 0).
    - App: budget lumens and light-reaching-diffuser with dimming, report Ben row,
    warm-up, spacing range, passive-lever filter,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
2026-10-15 Score evenness outside the blocked keepout corner; show whole face too
    The whole DXF corner is blocked on the prototype, so evenness (min/avg, CV,
    dimmest 5%) is scored and optimized on the lit face outside it. Whole-face
    values are reported alongside in the tile, light panel, checklist, compare
    panel and report. New check 26; outputs and docs regenerated.
2026-10-15 Show brightness and heat maps through the keepout zone
    The keepout is drawn as an outline with a light hatch when a map is on, and
    the darkest-to-brightest light scale includes the keepout corner.
2026-10-15 Add 55 mA power-budget baseline study (hex vs optimized, 21 mm, 3000 K)
2026-10-15 Thermal camera: IR view from the desk looking up, hottest point labelled
    The diffuser surface map is drawn just below the Head Front (or fallback
    shell) so it is visible from below; info line gives hottest, coolest and
    spread.
2026-10-15 Best-layout search at 21 mm / 55 mA / 3000 K and its report (PDF)
    12 starts (hex + Poisson/CVT), 20k iterations each, best polished 60k.
2026-10-15 Bench brief: Variation B = the whole-face-optimized layout; export its CSV and DXF
    [variation-B-layout.dxf, variation-B-led-coordinates.csv]
2026-10-15 Bench build: 20 LEDs (4x5) at a 22 mm minimum pitch; three condition reports (PDF)
    - best-layout.js takes a count and pitch, keeps only full-count starts, desk
    limit only for the full 60-LED array (fixes a 17-LED 'best' layout)
    - bench predictions, layout CSV/DXF exports and BENCH_TEST_BRIEF for 20 LEDs
    - reports: Baseline, A (foil, not modelled: banner) and B; full-head 60-LED
    files renamed
    - optimize() refuses an empty start layout
    [bench-B-optimized-20-layout.dxf, bench-B-optimized-20-led-coordinates.csv, bench-baseline-and-A-hex-20-layout.dxf, bench-baseline-and-A-hex-20-led-coordinates.csv, full-head-60-optimized-layout.dxf, full-head-60-optimized-led-coordinates.csv]
2026-10-15 Printable 1:1 string maps for the bench layouts; wiring-aware string grouping
    Strings grouped for least total wire with no wire crossing the keepout;
    CSVs gain position_in_string; maps (front and mirrored back) in
    reports/bench-string-maps.pdf.
    [bench-B-optimized-20-layout.dxf, bench-B-optimized-20-led-coordinates.csv, bench-baseline-and-A-hex-20-layout.dxf, bench-baseline-and-A-hex-20-led-coordinates.csv]
2026-10-16 Secondary light for the dark keepout corner; rear-light and scattering notes reviewed
    - Step 3 -> Secondary light: raised top-emitters, side-emitters or an edge-lit
    light guide, each with its own lm, W, beam (cos^m from FWHM) and distance.
    Added to the field as a fixed base, so evenness, light out, desk lux, the
    optimizer, snapshots and the report include it; its power goes into the
    heat map. Check 27; sweep in checks/aux-corner.js.
    - DXF re-check: the corner zone is the envelope of the part outlines and
    camera-board holes drawn in WT - Lewis.dxf; they are now drawn in the zone.
    - REAR_LIGHT_NOTES: Moreno fall-off (cos^4, 96%, d = 0.89 z), head pose,
    PLA thermal cap from the heat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
2026-10-16 Secondary light: light pipes fed from behind the board; correct light-guide input figures in the notes
    - New type 'pipe': LEDs behind the board feeding pipes up into the corner;
    the exit is the source (lm x pipe efficiency, exit beam, distance); LED
    heat still into the board. Check 27 and the corner sweep include it.
    - Notes said 60-120 lm into the guide; the sweep fed 120-240 lm (efficiency
    0.5) for 38-77 lm out of the face. Corrected, with the heat at that power.
2026-10-16 Reorganize: docs/, checks/output/, checks/data/, reports/{bench,full-head,geometry}; session report
    Files moved with git mv; every script path and doc reference updated.
    Checks (27/27) and regenerated outputs unchanged apart from the new path in
    one label. README gains a folder layout; docs/SESSION_REPORT.md added.
    [bench-B-optimized-20-layout.dxf, bench-B-optimized-20-led-coordinates.csv, bench-baseline-and-A-hex-20-layout.dxf, bench-baseline-and-A-hex-20-led-coordinates.csv, full-head-60-optimized-layout.dxf, full-head-60-optimized-led-coordinates.csv]
